jxg81/bin-light/bin-model.3mf

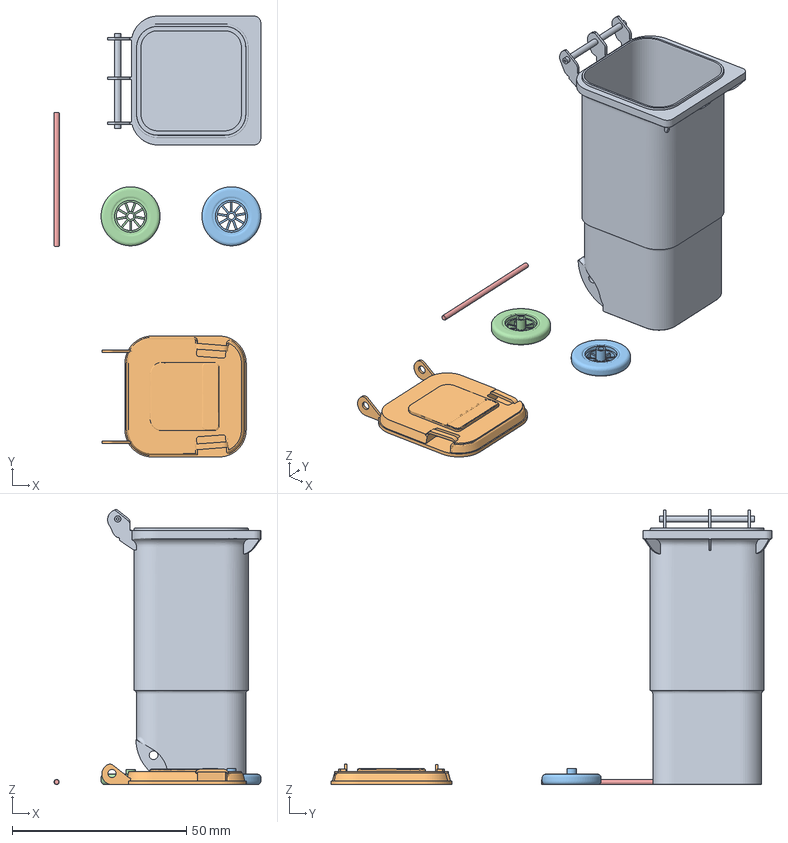
[picture p1: CAD file, 2026-07-25, last stored version]
bin-model.3mf
59.4 x 126.6 x 79.0 mm
Tonne 80 30.09.stl
Deckel-80 v5.stl
Rad-links-80.stl
Rad rechts-80.stl
Achse-80-v2.stl
