jxg81/bin-light/main/main.c

#include "esp_err.h"
#include "esp_event.h"
#include "esp_log.h"
#include "esp_netif.h"
#include "mdns.h"
#include "nvs_flash.h"

#include "buttons.h"
#include "led_state.h"
#include "ota.h"
#include "schedule.h"
#include "settings.h"
#include "time_sync.h"
#include "waste_api.h"
#include "web_server.h"
#include "wifi_manager.h"

static const char *TAG = "bin_light";

static esp_err_t nvs_init_with_erase_retry(void)
{
    esp_err_t err = nvs_flash_init();
    if (err == ESP_ERR_NVS_NO_FREE_PAGES || err == ESP_ERR_NVS_NEW_VERSION_FOUND) {
        ESP_ERROR_CHECK(nvs_flash_erase());
        err = nvs_flash_init();
    }
    return err;
}

static esp_err_t mdns_start(void)
{
    esp_err_t err = mdns_init();
    if (err != ESP_OK) {
        return err;
    }
    err = mdns_hostname_set("binlight");
    if (err != ESP_OK) {
        return err;
    }
    err = mdns_instance_name_set("Bin Light");
    if (err != ESP_OK) {
        return err;
    }
    return mdns_service_add(NULL, "_http", "_tcp", 80, NULL, 0);
}

void app_main(void)
{
    ESP_ERROR_CHECK(nvs_init_with_erase_retry());
    ESP_ERROR_CHECK(esp_netif_init());
    ESP_ERROR_CHECK(esp_event_loop_create_default());

    ESP_ERROR_CHECK(led_state_init());
    led_state_run_self_test();
    led_state_set((led_color_t){0, 0, 40}, 255); // dim blue = "booting"

    ESP_ERROR_CHECK(settings_init());

    // Before wifi_manager_start(), which blocks indefinitely in AutoAP mode.
    // A freshly-OTA'd image that can no longer reach the network would stop
    // right there, never reach ota_mark_valid() below, and never reboot - so
    // the bootloader would never get the reset it needs to roll back. Armed
    // here, the watchdog supplies that reset. No-op on an ordinary boot.
    ota_rollback_watchdog_start();

    // Before wifi, not after. wifi_manager_start() blocks for the whole AutoAP
    // session (SPEC.md 3.4), so starting mDNS afterwards left the responder
    // dead during setup - exactly when a memorable name is most useful, since
    // that is the one time the user has nothing written down. Started here it
    // is already listening when AutoAP raises the SoftAP, and the predefined
    // AP interface (CONFIG_MDNS_PREDEF_NETIF_AP) attaches it on AP_START, so
    // binlight.local resolves on the setup network as well as on the LAN.
    //
    // Safe this early: mdns_init() only needs esp_netif_init() and the default
    // event loop, both done above. It binds interfaces as they appear rather
    // than requiring one to exist already.
    if (mdns_start() != ESP_OK) {
        ESP_LOGW(TAG, "mDNS failed to start, device will only be reachable by IP");
    }
    if (wifi_manager_start() != ESP_OK) {
        ESP_LOGW(TAG, "starting without a confirmed Wi-Fi connection, will keep retrying in the background");
    }
    if (time_sync_start() != ESP_OK) {
        ESP_LOGW(TAG, "starting without a confirmed time sync, schedule will activate once time becomes valid");
    }

    ESP_ERROR_CHECK(schedule_init());
    ESP_ERROR_CHECK(waste_api_init());
    ESP_ERROR_CHECK(web_server_start());
    ESP_ERROR_CHECK(schedule_task_start());
    ESP_ERROR_CHECK(waste_api_task_start());
    ESP_ERROR_CHECK(buttons_start());

    // Everything is up and the device has proved it can serve pages, so a
    // freshly-OTA'd image is healthy. Until this runs, the bootloader will
    // roll back to the previous image on the next reboot - which is what
    // saves a physical visit if an update ever bricks the network path.
    ota_mark_valid();
    ESP_ERROR_CHECK(ota_auto_task_start());

    ESP_LOGI(TAG, "bin light ready (firmware %s)", ota_running_version());
}
