jxg81/bin-light/(commit log)

2026-07-25 Initial commit: bin light firmware (ESP32-C6)
    A bin-day reminder light: WS2812 LEDs on a Seeed XIAO ESP32-C6 that light
    in a colour matching which bin goes out, driven by council collection APIs
    with a manual fallback schedule and an on-device web UI.
    Implemented: Wi-Fi, web server, NVS-backed schedule, NTP + runtime timezone,
    independent per-colour frequency rules, Impact Apps (waste-info.com.au)
    integration with address wizard and per-event-type colour mapping, mDNS
    (binlight.local), dual-LED support and a boot self-test.
    SPEC.md is the source of truth for requirements, design decisions, verified
    council API details and current build/verification state - see its section 4
    for what is wri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
    [bin-model.3mf, partitions.csv]
2026-07-25 Fix default brightness of 0 that made the light permanently black
    brightness multiplies every colour channel in led_state_set_dual(), so a
    value of 0 renders black regardless of which colour the schedule resolved -
    indistinguishable from broken hardware. default_schedule() never assigned
    it, leaving the {0} zero-initialiser in place.
    This is very likely the real cause of the "Test button does nothing" report,
    which had been attributed solely to preview logic.
    Fixed in four parts, because the one-line default change alone would not have
    helped an already-flashed device:
    - default_schedule() sets SCHEDULE_DEFAULT_BRIGHTNESS (128, 50%)
    - schedule_init() self-heals a stored below-floor value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
    [schedule.c, web_server.c]
2026-07-25 Warm up yellow so it doesn't read green through the PLA enclosure
    WS2812 green is substantially more luminous than red at equal duty, so a
    naive (255,255,0) yellow reads distinctly green - confirmed on hardware
    viewed through the transparent PLA cover. Pull the green channel down to
    (255,150,0) in both COLOR_PRESETS and the boot self-test palette.
    This is a perceptual calibration against the real enclosure, not a bug, and
    sits alongside the existing RGB-byte-order finding in SPEC.md 2: expect to
    re-tune if filament, wall thickness or LED batch changes.
    Also make append_color_select() preselect the *nearest* preset instead of
    requiring an exact RGB match. Colours are persisted as literal RG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
    [led_state.c, web_server.c]
2026-07-25 Defer final yellow calibration to integration testing in the real enclosure
    Hardware testing confirms red, green and purple read correctly through the
    test cover - no further tuning needed there. Yellow remains problematic even
    at (255,150,0), and the testing established the cause is not just the
    red/green channel ratio: it is materially affected by viewing angle and
    diffraction through the cover.
    That makes it untunable against the flat test cover, since the production
    enclosure has different geometry and a divider between the two LEDs. Tuning
    it now would be re-work, so it is deferred rather than guessed at again.
    SPEC.md 5 records the deferred task with how to do it: judge it assembled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
2026-07-25 Record agreed next step: §3.11 Preferences UI reorganisation
    Decided with the owner to do the self-contained UI work before the larger
    §3.3 next-collection rework and the §3.13 council backends: it touches only
    web_server.c rendering and the POST /save parser, has no bearing on the risky
    backend refactor, and makes the device materially easier to use while the
    harder work is in flight.
    SPEC.md 4 now carries the scope (Preferences section, Manual / Fallback
    Schedule rename, CSS-only collapsible sections) and confirms the ordering
    after it is unchanged.
2026-07-25 Record hardware verification: brightness fix and Test button confirmed working
    Owner flashed the brightness and colour changes. Updating SPEC.md 4's
    written/flashed/verified status accordingly - nothing is now pending a flash.
    Confirmed working on hardware:
    - Display Next Collection button now lights the LEDs
    - brightness self-heal in schedule_init(), which repaired the stored
    zero-brightness v5 blob without a factory reset
    - red, green and purple read correctly through the enclosure
    Since the light was previously black and nothing else about colour resolution
    changed, the brightness-0 default was the real cause of the "Test button does
    nothing" report; the schedule_preview_next() relaxa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
2026-07-25 Reorganise home page around a Preferences section (SPEC 3.11)
    Brightness, On From, Turn off After, Light mode, Second LED default
    colour and Timezone applied regardless of which schedule was driving the
    light, but sat under "Manual schedule" (or, for Timezone, in a section of
    its own). They now live in a "Preferences" section at the top of the
    page.
    The API and Manual sections collapse to just their enable checkbox until
    ticked. This is CSS-only - the project has stayed no-JS everywhere else,
    and a cosmetic collapse isn't worth introducing the first bit of client
    script. Each section needs its own .sect wrapper: the general sibling
    combinator matches *every* later .details, so an unscoped r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
2026-07-25 Replace HTML_BUF_SIZE estimates with measured page sizes
    Compiled root_get_handler() on the host against stubs and dumped the
    bytes it actually emits, rather than guessing: 7145 factory-fresh, 8679
    for a realistic setup, 10877 worst case (8 colour-mapping rows). 12288
    leaves ~1.4KB over the worst case.
    The fresh-device figure is the notable one - the old 7200 buffer had 55
    bytes of headroom with nothing configured, so it would have truncated on
    any real setup. Recorded the harness technique in SPEC 3.11; it renders
    the firmware's real markup and catches truncation before the device does.
    [web_server.c]
2026-07-25 Rework the next-collection model around a sticky cache (SPEC 3.3)
    The old model reported "nothing known" whenever a poll's fixed 13-day
    window or 30-hour freshness timer didn't line up, even though a real
    future collection existed - so the light could go dark on a night it
    should have been lit. The device is now required to always know the next
    collection.
    waste_api: the cache is persisted to NVS and sticky. A poll that finds
    an event overwrites it; a poll that finds nothing, or fails outright,
    leaves it alone. The only thing that invalidates a cached date is the
    date itself passing - the freshness timer is gone. The recurring waste
    weekday is a separate signal with no expiry, since a weekl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
    [render_page.c, schedule.c, schedule.h, test_resolver.c, waste_api.c]
2026-07-25 Pick a council from a dropdown instead of typing a subdomain
    Setup asked for a free-text waste-info.com.au subdomain, which is
    frequently unguessable: Bayside Council is `rockdale`, Blue Mountains is
    `bmcc`, Horsham is `hrcc`, Queanbeyan-Palerang is `qprc`.
    Adds councils.c: a static table of the 39 Impact Apps councils with
    display name, state and backend param. /api-setup now offers a state
    dropdown (defaulting to VIC) and a council dropdown filtered to it.
    Filtering is server-side since there's no JavaScript, so changing state
    costs a page load - defaulting to VIC means a Victorian user never sees
    it. Two separate forms so it's clear which button does what.
    Only councils with a working b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
2026-07-25 Re-verify the four bespoke council endpoints; correct Merri-bek
    Probed all four before implementing against them. Knox and Whitehorse
    returned exactly the recorded shapes. Merri-bek did not, and following
    the recorded notes would have produced a backend that never worked.
    Corrections, all confirmed live:
    - cpage is a mandatory parameter and its value changed, 86612 -> 183782.
    Omitting it returns every field null with "noService", which reads as
    an unserviced address rather than a malformed request.
    - The parameter names are the form field names (xPoint, wasteRateCode,
    glassWeekNumber, ...), not the ArcGIS field names forwarded verbatim.
    - Coordinates are ignored entirely. The council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
2026-07-25 Implement all four bespoke council backends (SPEC 1.2 working group)
    Knox, Whitehorse, Merri-bek and Monash, in one pass, against endpoints
    re-verified the same day. With this, every council in the critical
    working group has a working backend - the definition of done from
    SPEC 1.2.
    The abstraction that made four backends cheap: each is just a fetch
    function and a search function. Every backend normalises its streams
    onto the existing event vocabulary (waste/recycle/organic/glass), so
    type rules, the weekly-waste ignore default, the colour table, the
    sticky cache, the resolver and both UIs needed zero backend-specific
    changes. fetch_events_for_config() is the single dispatch point;
    waste_api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
    [councils.c, councils.h, date_parse.c, date_parse.h, render_page.c, test_backends.c, test_dates.c]
2026-07-25 Merri-bek: self-discover cpage, year-derived URLs, setup guidance
    Further live probing refined the cpage failure model: it must be a real
    CMS page id (the old 86612 still works because that page still exists;
    a made-up id gets HTTP 500). So the risk is old pages being deleted
    after the annual rotation, and the fix is discovery, not a constant.
    The current id is embedded in the calendar page's HTML, but only in the
    response to the address-form POST - the plain GET page doesn't carry
    it. When /api/AddressDetails actively rejects a request (500 or the
    all-null "no service" body) while the network is up, the device POSTs
    its saved fields to the year-derived calendar URL (waste-calendar26/ in
    20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
    [test_backends.c, waste_api.c, waste_api.h, web_server.c]
2026-07-25 Implement AutoAP Wi-Fi provisioning (SPEC 3.4)
    Wi-Fi credentials were Kconfig-only, which meant a per-recipient rebuild
    and asking people to hand over their password to be compiled into a
    binary. SPEC 1.1 calls this a hard blocker for giving devices away.
    Credentials now come from NVS, provisioned at runtime. With none stored
    (or when the stored network can't be joined at boot) the device raises an
    open SoftAP named binlight-XXXX from the last 4 hex of its station MAC,
    breathes both LEDs white, and serves a no-JS page at 192.168.4.1 to pick
    a network and enter its password.
    Hand-rolled rather than using the wifi_provisioning component: that
    component's SoftAP transport speaks protobuf/prot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
2026-07-26 Correct a stale status row: the bespoke backends have their own row now
    The '§3.13 additional council backends: not written' row predated the four
    bespoke backends landing and read as though none existed. Split it into what
    actually remains - South Australia - and gave OTA its own row rather than
    leaving it visible only in prose.
2026-07-26 Add factory reset: shared function, confirmed UI action (SPEC 3.12)
    factory_reset.c holds the single implementation both entry points use -
    the web UI now, the physical reset button later. It wipes the schedule
    and colour rules, the council/API config and its cache, the timezone,
    and the Wi-Fi credentials, then reboots into AutoAP setup.
    Two things that are easy to get wrong here:
    State is split across TWO NVS namespaces - "binlight" holds most of it
    but the timezone lives in "binlight_cfg", a split dating from settings.c
    being written separately. Erasing only the obvious one leaves a
    "factory-fresh" device still in its old timezone. Nothing at the call
    site makes that visible, so the list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
    [factory_reset.c, factory_reset.h, render_page.c, web_server.c]
2026-07-26 Add restart action and the reset button (3s restart / 10s factory reset)
    Adds POST /reboot and a Restart button on the home page - no
    confirmation step, since unlike the two resets it loses nothing. The
    response page auto-refreshes back to / after 12s.
    Implements the physical reset button in buttons.c with the durations
    specified: under 3s does nothing, 3-10s restarts, 10s or more factory
    resets. This supersedes the earlier 5-second long-press proposal.
    Two design points worth calling out.
    The action fires on RELEASE, not on reaching the threshold, so letting
    go early is always a safe cancel and there are seven seconds to change
    your mind after restart arms.
    And the LEDs show which actio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
    [buttons.c, buttons.h, gpio.h, main.c, test_buttons.c, web_server.c]
2026-07-26 Log button presses on debounce; record the final input hardware plan
    Logs as soon as a press debounces, not just on release. When the
    "button" is a jumper wire on a breadboard, waiting 3 seconds for the LED
    feedback to confirm the wiring works is a poor first signal.
    Records in SPEC 3.12 that the reset input being active-low with the
    internal pull-up means a bare GPIO-to-GND jumper is a working button,
    and that GPIO 9 is the XIAO's BOOT button so it needs no wiring at all.
    Also records the owner's final input plan - capacitive touch for the
    action button, push button for reset - and the three things that follow
    from it, before the action button gets built:
    The ESP32-C6 has no touch periph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
    [buttons.c, buttons.h]
2026-07-26 Move the reset button to an external pin (GPIO 2), off the BOOT button
    The board goes inside a sealed enclosure, so the on-board BOOT button is
    unreachable and the reset button has to be panel-mounted on its own pin.
    Default changes 9 -> 2 (pad D2 on the XIAO ESP32-C6): broken out, no
    special function, and unlike 9 not a strapping pin - which also removes
    the "don't hold it through a power-up" caveat entirely. GPIO 4, 5, 8, 9
    and 15 are all strapping pins on the ESP32-C6 and are wrong for any
    panel button, since one held across a power-up changes how the chip
    boots.
    Pin allocation is now GPIO 0 (D0) WS2812 data, GPIO 2 (D2) reset button,
    with D1 pencilled in for the capacitive touch module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
    [buttons.h]
2026-07-26 Add the capacitive action button: dismiss tonight / show next collection
    Completes the two-button design. The capacitive pad on D1 taps to
    dismiss the light if it's on, or show the next collection for 30s if
    it's off; the push button on D2 keeps restart/factory reset.
    schedule.c decides what a tap means, not buttons.c - "is the light on?"
    is the schedule's state, and the button layer only reports that a press
    happened.
    Dismissal is keyed to a collection DATE, not a timer.
    schedule_suppress_current() records the date the light is showing, the
    evaluator skips it, and the suppression drops itself once the resolved
    next collection moves on. Nothing to expire, no resume to forget, and it
    surviv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
    [buttons.c, schedule.c, schedule.h, test_buttons.c, test_resolver.c]
2026-07-26 Spec: deep sleep with radar presence wake (SPEC 3.14), design only
    Records the battery-saving design: deep sleep when nobody's there, woken
    by an HLK-LD012-5G radar module, with a runtime on/off toggle in
    Preferences defaulting to off (mains builds and debugging want it off).
    The headline finding is a pin conflict, not a software question. On the
    ESP32-C6 only GPIO 0-7 can wake the chip from deep sleep - they're the
    LP/RTC-capable pins - and all three of those the XIAO appears to break
    out are already taken by the LED data line and the two buttons. GPIO 4,
    5, 8, 9, 15 are strapping pins and unusable; D3-D10 are believed to map
    to GPIO 16-23, none of which can wake anything. So the radar can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
2026-07-26 Spec: drop the radar, reframe 3.14 around where the power actually goes
    The LED premise was wrong and the owner caught it: WS2812s idle at ~1mA
    each because their own controller ICs are powered from the 5V rail.
    Deep-sleeping the MCU only stops it driving the data line - the LEDs
    neither know nor care. Cutting that needs a switch in the LED rail, and
    no amount of MCU sleeping substitutes for it.
    Working the budget shows the radar was optimising the wrong thing by
    about 350x. Its 70uA is 1.7 mAh/day against a 600 mAh/day problem. Two
    consumers dominate and they're roughly equal: the always-connected radio
    (~600 mAh/day) and the light actually being on (~600 mAh on a 20-hour
    bin night). LED i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
2026-07-26 Spec: record the hardware test results - two features remain untested
    Owner tested the current build. Everything is flashed and working on
    hardware except factory reset (via web UI or the button's 10s hold) and
    AutoAP onboarding.
    That retires several standing uncertainties: both buttons work, which
    confirms the GPIO 2 / GPIO 1 assignments and the touch module's
    active-HIGH polarity - all three were guesses from published pinouts.
    LED2 and the boot self-test, flagged as assumed-but-unconfirmed since
    before the last compaction, are also now verified.
    The two remaining gaps are related: both destroy working configuration,
    which is exactly why they've been left, and a factory reset lands the
    d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
2026-07-26 Add OTA updates hosted entirely on GitHub (SPEC 3.5)
    No backend: the device fetches firmware/latest.json from raw
    .githubusercontent.com, compares its version against the running one,
    and streams the image from a GitHub Release asset. Publishing an update
    is a tag, a release and a one-line commit - firmware/README.md has the
    checklist.
    The partition table changes from one 3MB factory slot to ota_0/ota_1 at
    1.94MB each (image is 1.29MB, 35% headroom). nvs deliberately stays at
    0x9000 at the same size, so schedule, council setup, Wi-Fi credentials
    and the collection cache should all survive the switch - the app moves
    from factory to ota_0 but keeps the same 0x20000 start. Worth confirming
    on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
    [partitions.csv]
2026-07-26 OTA: automatic updates on by default; verify the GitHub TLS chain
    Auto-update defaults to on. These devices live in other people's houses,
    and the reason OTA exists at all is that a council API breaking otherwise
    means visiting each one with a cable - leaving updates for someone else
    to notice and click would defeat that.
    Checks daily, first check ~2 minutes after boot so Wi-Fi and SNTP have
    settled. After installing it waits for the light to go off before
    restarting, so an update never interrupts a bin-night reminder.
    Rollback is what makes leaving this on defensible: a build that can't get
    back onto Wi-Fi is never confirmed by ota_mark_valid(), so the bootloader
    reverts it on the next re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
    [main.c, ota.c, ota.h, render_page.c, schedule.c, schedule.h, web_server.c]
2026-07-26 Spec: correct stale environment facts and section headings before compaction
    The Environment section claimed three things that are all now false and
    would actively mislead a fresh session: that this isn't a git repo, that
    the assistant has no ESP-IDF toolchain, and that Wi-Fi credentials sit in
    Kconfig as plaintext. Replaced with what's actually true, including the
    EIM activation script (the documented export.sh path doesn't exist here)
    and the host test command.
    Adds the sdkconfig-caches-Kconfig-defaults trap, which already bit once
    when the reset button GPIO default moved from 9 to 2 and the build kept
    using 9.
    Adds a Repository and history section recording the address scrub, the
    delete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
2026-07-26 Spec: OTA build is flashed; partition change is live
    Owner flashed the current code, so the new two-slot OTA partition table
    is in place and the device reports 1.0.0. What's still untested is the
    update round trip itself - nothing has been published for it to find -
    plus factory reset and AutoAP.
2026-07-26 Record the WS2812B-V5 LED candidate; make the RGB byte-order note batch-conditional
    Considering GlowBit WS2812B-V5 parts for the production build, to delete the
    3.3V->5V logic-level converter. Nothing bought and no code changed - but the
    analysis is done, and it collides with a §2 instruction that would otherwise
    mislead.
    §2 said flatly "do not correct this back to GRB". That is right for the LEDs
    currently wired and wrong for a V5, whose datasheet mandates GRB - a future
    session obeying it after an LED swap would ship red and green swapped. Reframed
    as "match the hardware you have", with a pointer to §5.
    §5 records what the change would actually cost: the V5's 2.7V VIH (vs 3.5V) is
    wh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
2026-07-26 Fix factory reset: Wi-Fi survived it, and it hung after erasing
    Two bugs found by the first real hardware test of factory reset.
    1. The compiled-in Kconfig Wi-Fi pair silently defeated both factory reset and
    "forget Wi-Fi". wifi_manager_start() falls back to CONFIG_BINLIGHT_WIFI_SSID
    whenever NVS holds no credentials - which is exactly the state a reset
    creates. So the device erased everything, rebooted, found the build-time
    pair and rejoined the old network, and AutoAP was unreachable.
    The Kconfig defaults were correctly empty; the values were stale in the
    gitignored sdkconfig, so nothing in the tracked tree looked wrong. Second
    instance of the sdkconfig-caches-Kconfi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
    [factory_reset.c, wifi_manager.c, wifi_manager.h]
2026-07-26 Make binlight.local work during AutoAP setup, not just on the LAN
    The setup pages quoted a raw 192.168.4.1 because that was the only thing that
    worked: mdns_start() ran *after* wifi_manager_start(), which blocks for the
    whole AutoAP session, so the responder was dead for the entire setup flow -
    the one moment a memorable name is worth most, since it is the only time the
    user has nothing written down and no DHCP lease to look up.
    Moved mdns_start() ahead of wifi_manager_start(). Safe there: mdns_init()
    needs only esp_netif_init() and the default event loop, and binds interfaces
    as they appear. CONFIG_MDNS_PREDEF_NETIF_AP defaults to y (confirmed in
    build/config/sdkconfig.h), so the responder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
    [main.c, web_server.c, wifi_manager.c, wifi_manager.h]
2026-07-26 Add a captive portal to AutoAP so the setup page opens by itself
    Two halves, both live only while the SoftAP is up.
    captive_dns.c binds UDP :53 and answers every A query with the SoftAP's own
    address, read from the netif rather than hardcoded. Non-A queries - AAAA above
    all, which every phone asks alongside A - get an empty NOERROR rather than
    silence, because silence costs the client a multi-second timeout.
    prov_redirect_err_handler is registered as the provisioning server's 404
    handler and 302s everything unknown to the setup page. Together these mean the
    phone's connectivity probe (/generate_204, /hotspot-detect.html,
    /connecttest.txt) lands here instead of at Google/Apple/Microsoft; ea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
    [captive_dns.c, captive_dns.h, test_captive_dns.c, wifi_manager.c]
2026-07-26 Close out the last three hardware tests; record that OTA is blocked on repo visibility
    All three cleared on hardware 2026-07-27: the reset button's 10s hold (with a
    ~5s release restarting rather than wiping, so the 3s/10s discrimination is
    proven), wrong-password rejection at provisioning, and "forget this network" -
    the last confirming bug 21 is fixed on that path too, which the factory-reset
    test did not cover since it runs different code.
    That leaves OTA, and it turns out to be blocked rather than merely untested.
    The manifest URL points at raw.githubusercontent.com and the repo is private,
    so an unauthenticated fetch 404s - verified. The device is unauthenticated: it
    sends no token and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
2026-07-26 Remove identifying details from the working tree ahead of publishing
    Two changes, both about what a public repo would expose.
    §1.2 named Maribyrnong as "(home)". Dropped the annotation; the council set
    still implies a Melbourne suburb, which was accepted as a judgement call rather
    than a leak.
    The Merri-bek setup tip carried a real, verified-working example address. That
    is somebody's dwelling, and publishing it would put it both in the repo and on
    the screen of every device. Replaced with a format template.
    Checked whether a public building could serve as a working example instead -
    the ArcGIS layer is residential-only and the civic centre returns no features,
    so any example that actual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
    [web_server.c]
2026-07-26 Bump version to 1.0.1 for the first OTA round-trip test
    First real exercise of §3.5: the GitHub TLS chain from the device, the ~1.3MB
    download into the spare slot, and rollback. Content change over 1.0.0 is the
    Merri-bek example-address template, which doubles as an observable confirmation
    that the update actually took - not just a version string ticking over.
2026-07-26 Publish 1.0.1 in the OTA manifest
    Asset first, manifest second, per firmware/README.md - publishing the manifest
    before the asset exists means every device checking in the gap gets a failed
    download.
2026-07-26 Fix OTA download failing at GitHub's redirect; answer GET /update
    First real OTA attempt (device 1.0.0, manifest 1.0.1) got as far as detecting
    the update and then failed on every download:
    E HTTP_CLIENT: Out of buffer
    E esp_https_ota: Failed to open HTTP connection: ESP_FAIL
    A GitHub release URL 302s to release-assets.githubusercontent.com with a signed
    URL. Measured it: 909 characters, 864 of them path+query, giving an 880-byte
    request line. After a redirect esp_http_client composes that line into a buffer
    of buffer_size_tx, which defaults to 512, and bails
    (http_client_prepare_first_line, esp_http_client.c:1750). Set buffer_size_tx to
    4096 and buffer_size to 2048 explicitly. 4096 is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
    [ota.c, web_server.c]
2026-07-26 Publish 1.0.2 in the manifest; document two release-publishing traps
    Both hit for real while publishing this one.
    gh release create file#label sets the display label, not the filename - the
    download URL uses the real filename, so uploading a temp file named
    bin-light-102.bin produced a URL no device would ever request.
    And GitHub caches the 404: after fixing the upload, the plain URL kept 404ing
    for minutes while ?cb=1 returned 200. Probing a release URL before the asset
    exists under that name poisons it - the same hazard the asset-before-manifest
    rule already guards against, arriving from a different direction.
    Verified before pointing the manifest at it: plain URL 200, and the hosted
    as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
2026-07-27 Record the OTA round trip as verified on hardware
    Device went 1.0.2 -> 1.0.3 unattended: the daily auto-checker found the
    manifest, followed GitHub's signed redirect, pulled ~1.3MB over TLS into the
    spare slot, flashed, rebooted and came back healthy on 1.0.3. Confirmed from
    the device's own /update page, which also verifies bug 24 (GET now 200).
    That closes the §1.1 argument for OTA - a council-API break is now a push
    rather than a house call - and it took two bugs found only by actually trying
    it, neither visible from reading the code.
    Rollback is now the only untested thing in the project. Wrote the sequence
    down, including the part that is easy to get wrong: auto-update must be turned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
2026-07-27 TEMPORARY: point the manifest at the broken rollback-test image
    REVERT THIS AS SOON AS THE TEST IS DONE. Restore 1.0.3 and delete the
    v0.0.0-rollback-test release.
    Safe only because auto-update is off on the only device (verified from its
    /update page, not assumed). With auto-update on, a device would roll back and
    immediately re-fetch this image forever - difference-not-ordering versioning
    has no notion of 'that one was bad'.
2026-07-27 Revert the manifest to 1.0.3 after the rollback test
    Rollback confirmed: the device came back on 1.0.3 by itself once restarted.
    Removing the broken image from the manifest and deleting its release so it can
    never be selected again.
2026-07-27 Restart immediately after a manual OTA install; record rollback results
    The rollback test proved the safety net but also exposed why it looked broken:
    a manual install flashed the image and then waited for a second button press,
    so nothing visibly happened. The captured log shows the update being installed
    twice before the device was power-cycled.
    ota_start() now takes restart_when_done, because the callers want opposite
    things. Manual install passes true and the task reboots 4s after the write -
    long enough for the 3s page refresh to render "restarting now" once, so the
    user sees a result rather than a dead socket. The automatic updater passes
    false and keeps its own restart, which waits f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
    [ota.c, ota.h, web_server.c]
2026-07-27 Add a pending-verify rollback watchdog; release 1.0.4
    Closes the gap the rollback test exposed. Bootloader rollback is decided at
    boot, so it needs a reset. A new image that crashes supplies one and is
    reverted automatically - verified on hardware. A new image that boots but hangs
    does not: most plausibly one that can no longer reach Wi-Fi, so it waits in
    AutoAP for a human who never comes. That is the likelier real break and the one
    that costs a physical visit.
    ota_rollback_watchdog_start() arms a one-shot 10-minute timer when the running
    image is PENDING_VERIFY. If ota_mark_valid() has not run by the time it fires,
    it calls esp_ota_mark_app_invalid_rollback_and_reboot(), supplying the res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
    [main.c, ota.c, ota.h]
2026-07-27 Record that OTA-path changes are validated one release late
    Caught by the owner: suggesting the 1.0.4 install would demonstrate its own
    "manual installs restart themselves" was wrong. 1.0.3 performed that install
    and 1.0.3 waits for a button.
    The rule is a property of the mechanism, not a one-off slip, so it is written
    down in both places a future session would look. Everything up to and including
    the reboot decision - manifest fetch, version compare, download, buffer sizes,
    whether it restarts - runs in the image being replaced. Only behaviour from the
    new image's first boot onward is the new code.
    Useful corollary in the other direction: 1.0.4's own arrival did exercise the
    watchdog's ar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
2026-07-27 Make the rollback watchdog a task, not a software timer
    Caught while preparing the hang test, before running it. A timer callback runs
    on the timer service task, whose stack is 2048 bytes, and
    esp_ota_mark_app_invalid_rollback_and_reboot() writes the otadata partition.
    Flash operations on a 2KB stack are at best uncomfortably tight.
    What makes it worth fixing rather than risking is how it would have failed. A
    stack overflow panics, the panic reboots, and the reboot rolls the image back -
    because it is still PENDING_VERIFY. The device recovers, the test looks like a
    pass, and nothing about the watchdog has been demonstrated. A wrong mechanism
    producing the right outcome cannot be spotted fro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
    [ota.c]
2026-07-27 TEMPORARY: point the manifest at the hang-test image
    REVERT AS SOON AS THE TEST IS DONE. Restore 1.0.4 and delete the
    v1.0.5-hangtest release.
    Safe only because auto-update is off on the only device, confirmed from its
    /update page rather than assumed.
2026-07-27 Release 1.0.6: task-based rollback watchdog
    Ships the watchdog fix that until now existed only in the throwaway hang-test
    build. 1.0.4, which is what the device is running, still has the timer version
    whose callback would write flash on a 2KB stack.
    No functional change beyond that.
2026-07-27 Add UI-SPEC.md: design the web UI for the people who receive these
    Phase 1 is analysis and design only; no implementation. UI-SPEC.md is to UI
    decisions what SPEC.md is to functional ones, and the split is real: anything
    that would change device behaviour is quarantined in its section 9 rather
    than absorbed into a visual refactor.
    Headline finding: on a factory-fresh device / contains exactly two links and
    both are display:none, because the only route to setup sits inside a .details
    block revealed by a checkbox labelled "Use automatic bin collection API". A
    recipient who does not know what an API is has no way forward.
    Also measured: 104px of horizontal overflow on a 375px phone, caused
    st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
2026-07-27 Release 1.0.7: restrict where OTA images may come from, harden the web UI
    ota_start() now refuses any image URL outside CONFIG_BINLIGHT_OTA_URL_PREFIX,
    and ota_task_fn() refuses any image whose own esp_app_desc_t version is below
    CONFIG_BINLIGHT_OTA_MIN_VERSION. Both are pure input validation on data the
    device already has: no extra round-trip, no new precondition, and nothing a
    legitimate release can fail. They live in ota.c rather than the web handler so
    no caller can bypass them.
    The URL check sits *after* the OTA_STATE_RUNNING guard, not before it, so a
    refused URL can never set_state(FAILED) over an install already in progress -
    auto_task_fn() watches that state to decide when to reboo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
    [ota.c, render_page.c, web_server.c]
2026-07-27 Correct the 1.0.7 status, and record the sdkconfig trap that nearly shipped
    Two fixes to claims I got wrong in the previous commit.
    1.0.7 is now built and published, so the "never been built by the ESP-IDF
    toolchain" note was false; the status rows now separate "built + published"
    from "run on a device", which is the part still outstanding. The build command
    was in §4 Environment facts the whole time.
    More importantly: sdkconfig had cached CONFIG_BINLIGHT_OTA_MIN_VERSION="1.0.7"
    from an earlier build, so moving the Kconfig default to "1.0.6" did not reach
    the image - the build said `Using default value from sdkconfig ("1.0.7")` and
    would have shipped a floor forbidding the very rollback t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
2026-07-27 UI-SPEC: bin colours are fixed; make the interface palette not a bin colour
    Owner's direction: reliable colour reproduction in the enclosure matters more
    than flexibility, so nothing may alter the colour options outside the four
    calibrated presets.
    Three consequences:
    - Fix an error in the section 7.1 example markup, which printed the Green
    swatch as #008000. The preset is (0,255,0) = #00ff00. Exactly the drift the
    rule exists to prevent, and it was in the reference markup phase 2 would
    have transcribed.
    - Change the interface accent from green #2f6d4f to slate blue #2c5d8a, and
    the destructive colour from #a33 to #9b2c2c. A green accent button beside a
    green bin swatch teaches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
2026-07-28 UI-SPEC: owner review round 1 — six directives
    1. The Wi-Fi handover becomes a real, numbered step (new 4.4.1). The AP is torn
    down ~4s after the success page renders, so that page is the last thing the
    device can say before it is unreachable. It now carries the whole handover:
    what will happen, that the PHONE must rejoin the home network, and what to
    do when binlight.local doesn't resolve. Previously one paragraph.
    2. The waste-info.com.au subdomain field is removed from /api-setup and
    replaced by a link to manual setup (9.7). It asked a non-technical user to
    extract a subdomain from a council URL. This withdraws a capability, so it
    is recorded in section 9 rather th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
2026-07-28 UI-SPEC: offer manual setup wherever the council can't be reached
    Owner's direction: the S3 home card and the /api-test fetch failure should
    link to manual setup. Extended to the two /api-setup lookup failures as well -
    same failure class, same answer, and the setup-time one is the only state that
    can block onboarding outright. Flagged in the mockup as an extension rather
    than assumed; easy to pull back to the two named.
    Manual setup is now the answer to four questions, so 4.5.1 records two rules
    that keep it from taking over:
    - Always a quiet text link, never a second primary button. A council outage is
    usually temporary and the automatic path recovers by itself, so it stays the
    prima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
2026-07-28 UI: shared stylesheet, and bin colours that look like bins
    First increment of the approved UI-SPEC work. Additive and self-contained -
    no page has been restructured yet.
    - COLOR_PRESETS gains a display value per preset (#d93025 / #1e8e3e /
    #f9c22e / #8e44ad). The emitted RGB is untouched: it is enclosure
    calibration, and (255,150,0) renders as orange on a phone precisely because
    it is green-channel compensation for PLA. The user should meet the bin, not
    the workaround. Display values never reach NVS, an <option value>, or the
    LED - a save round-trip is byte-identical to before.
    - New /s.css, cached a week like the favicon already is. Its bytes stop
    counting against HTML_BUF_SIZ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
    [render_page.c, web_server.c]
2026-07-28 Correct the floor status: 1.0.8 closed it in source, but nothing is published
    My previous commit said the floor "currently ships at 1.0.6". Release 1.0.8
    landed while that was being written and raised it to 1.0.7, so the statement was
    wrong the moment it was pushed.
    The accurate position has two halves, and collapsing them is what made it wrong:
    the source tree is closed (Kconfig and sdkconfig both 1.0.7), while the field is
    not - firmware/latest.json still names 1.0.7 and no v1.0.8 release exists, so
    the only device that exists still runs a 1.0.6 floor and can still be walked
    back onto firmware predating the checks. Fixed in 3.5.3, in the 4 status row and
    in the ship-gate blockquote, all t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
2026-07-28 Publish 1.0.8: the version floor is now closed in the field
    Asset verified 200, byte-identical to the local build, and declaring 1.0.8
    before the manifest was pointed at it. The floor that actually reached the
    image was confirmed in build/config/sdkconfig.h, not just in Kconfig - the
    trap SPEC 4 records as having bitten three times.
    This is the release the ship gate was waiting on. Once a device takes it, its
    floor is 1.0.7 and it can no longer be walked back onto firmware predating the
    OTA checks.
    Note the one-way step that follows: rollback to 1.0.6 or earlier is refused
    from here on, permanently and by design. Bootloader rollback (SPEC 3.5.1) is
    unaffected - that is a different mechanis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
2026-07-28 1.0.8 is on the device: the ship gate is closed and the OTA gates are proven
    The bench device took 1.0.8 over the air and is healthy. Three things change.
    The version floor is closed in the field, not just in source. §3.5.3 no longer
    needs the source-vs-field split; it keeps the history of why 1.0.7 shipped a
    1.0.6 floor, because the release list otherwise looks like an oversight, and it
    records that the step is one-way: 1.0.6 and earlier are refused permanently
    now. Bootloader rollback is unaffected - it does not consult the floor.
    The accept path of both OTA gates is now verified on hardware, which §3.5.0
    said the introducing release could not show. The condition was met the ordinary
    w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
2026-07-28 UI: a home page that answers the question, and /settings for the rest
    The home page now says which bin goes out. It never has: the device has always
    resolved this - schedule_get_next_collection() is read-only and was already
    there - and the page showed nine headings of settings instead, none of which
    answered it.
    More seriously, a factory-fresh device offered no way to set itself up. The
    only two links on / were both inside a collapsed .details block, revealed by a
    checkbox labelled "Use automatic bin collection API". Someone who does not
    know what an API is had no route forward at all. That is fixed: unconfigured,
    the page is one card and one button.
    Also now visible: the clock-not-synced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
    [render_page.c, settings.c, settings.h, test_settings_tz.c, web_server.c]
2026-07-28 AutoAP: make the handover a real step, and bound the scan list by bytes
    Two changes to the page a new owner sees before anything else works.
    The success page now carries the whole handover instead of one paragraph.
    run_autoap() tears the AP down AUTOAP_LINGER_MS after that page renders, so it
    is the last thing the device can say before it is unreachable, and what
    happens next depends entirely on the user realising - unprompted - that their
    PHONE has to move back to their own network. Nothing on screen can help them
    once the AP is gone. It is now a numbered step, with what to do when
    binlight.local doesn't resolve. No IP fallback is offered because there isn't
    an honest one: the device doesn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
    [wifi_manager.c]
2026-07-28 Release 1.0.9: the UI rewrite, plus the copy passes the binary caught
    Finishes the wording work on the pages the earlier commits restructured but
    did not reword. Found by grepping the built .bin rather than the source: the
    factory-reset confirmation was still listing "the council and address setup,
    and the bin colour mapping", "the manual / fallback schedule and its colour
    rules" and "both LEDs breathing white", and the update page still said
    "Running version" and "Download and install". The AutoAP page still titled
    itself "Bin Light Setup" despite its body copy having moved on.
    Zero occurrences of the old implementation vocabulary remain in the shipped
    image: no "Bin Collection API", no "M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
    [web_server.c, wifi_manager.c]
2026-07-28 Publish 1.0.9: the web UI rewrite goes out
    Asset verified before the manifest moved, in that order, per
    firmware/README.md - publishing first means every device checking in the gap
    gets a failed download.
    - asset is literally named bin-light.bin, not a gh #label
    - 1326288 bytes, matching the local build exactly (0x143cd0)
    - the plain download URL returned 200 before this commit was written, and
    was not fetched before the asset existed - GitHub caches the 404
    - manifest version matches version.txt
    - url clears CONFIG_BINLIGHT_OTA_URL_PREFIX
    - notes are 89 chars against OTA_NOTES_MAX_LEN of 95
    Per SPEC 3.5.0 the install path exercised here belongs to 1.0.8, not to this
    image: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
2026-07-28 Release 1.0.10: finish /api-test, and make plain English a test
    Interrogating the running 1.0.9 found /api-test still in the old voice. Its
    title, back link and swatch column had been done; the restructure and the copy
    pass had not. It still said "raw data for the next 28 days (nothing filtered
    out yet)", "event types", "Colour mapping", and headed its table Type/Ignore -
    and the mapping still sat below the diagnostic table rather than above it.
    That page is step 2 of onboarding, so it mattered more than most.
    Now: mapping first, evidence second. "Which colour is which bin", Bin /
    Don't remind me / Colour, and an explicitly optional offer of the manual
    fallback at the end. The failure stat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
    [render_page.c, web_server.c]
